prozessorkern/AudioPlayer/pcb/Audioplayer_OG_Prototyp.kicad_pcb

## KiCad design pcb/Audioplayer_OG_Prototyp.kicad_pcb (2018-02-16)

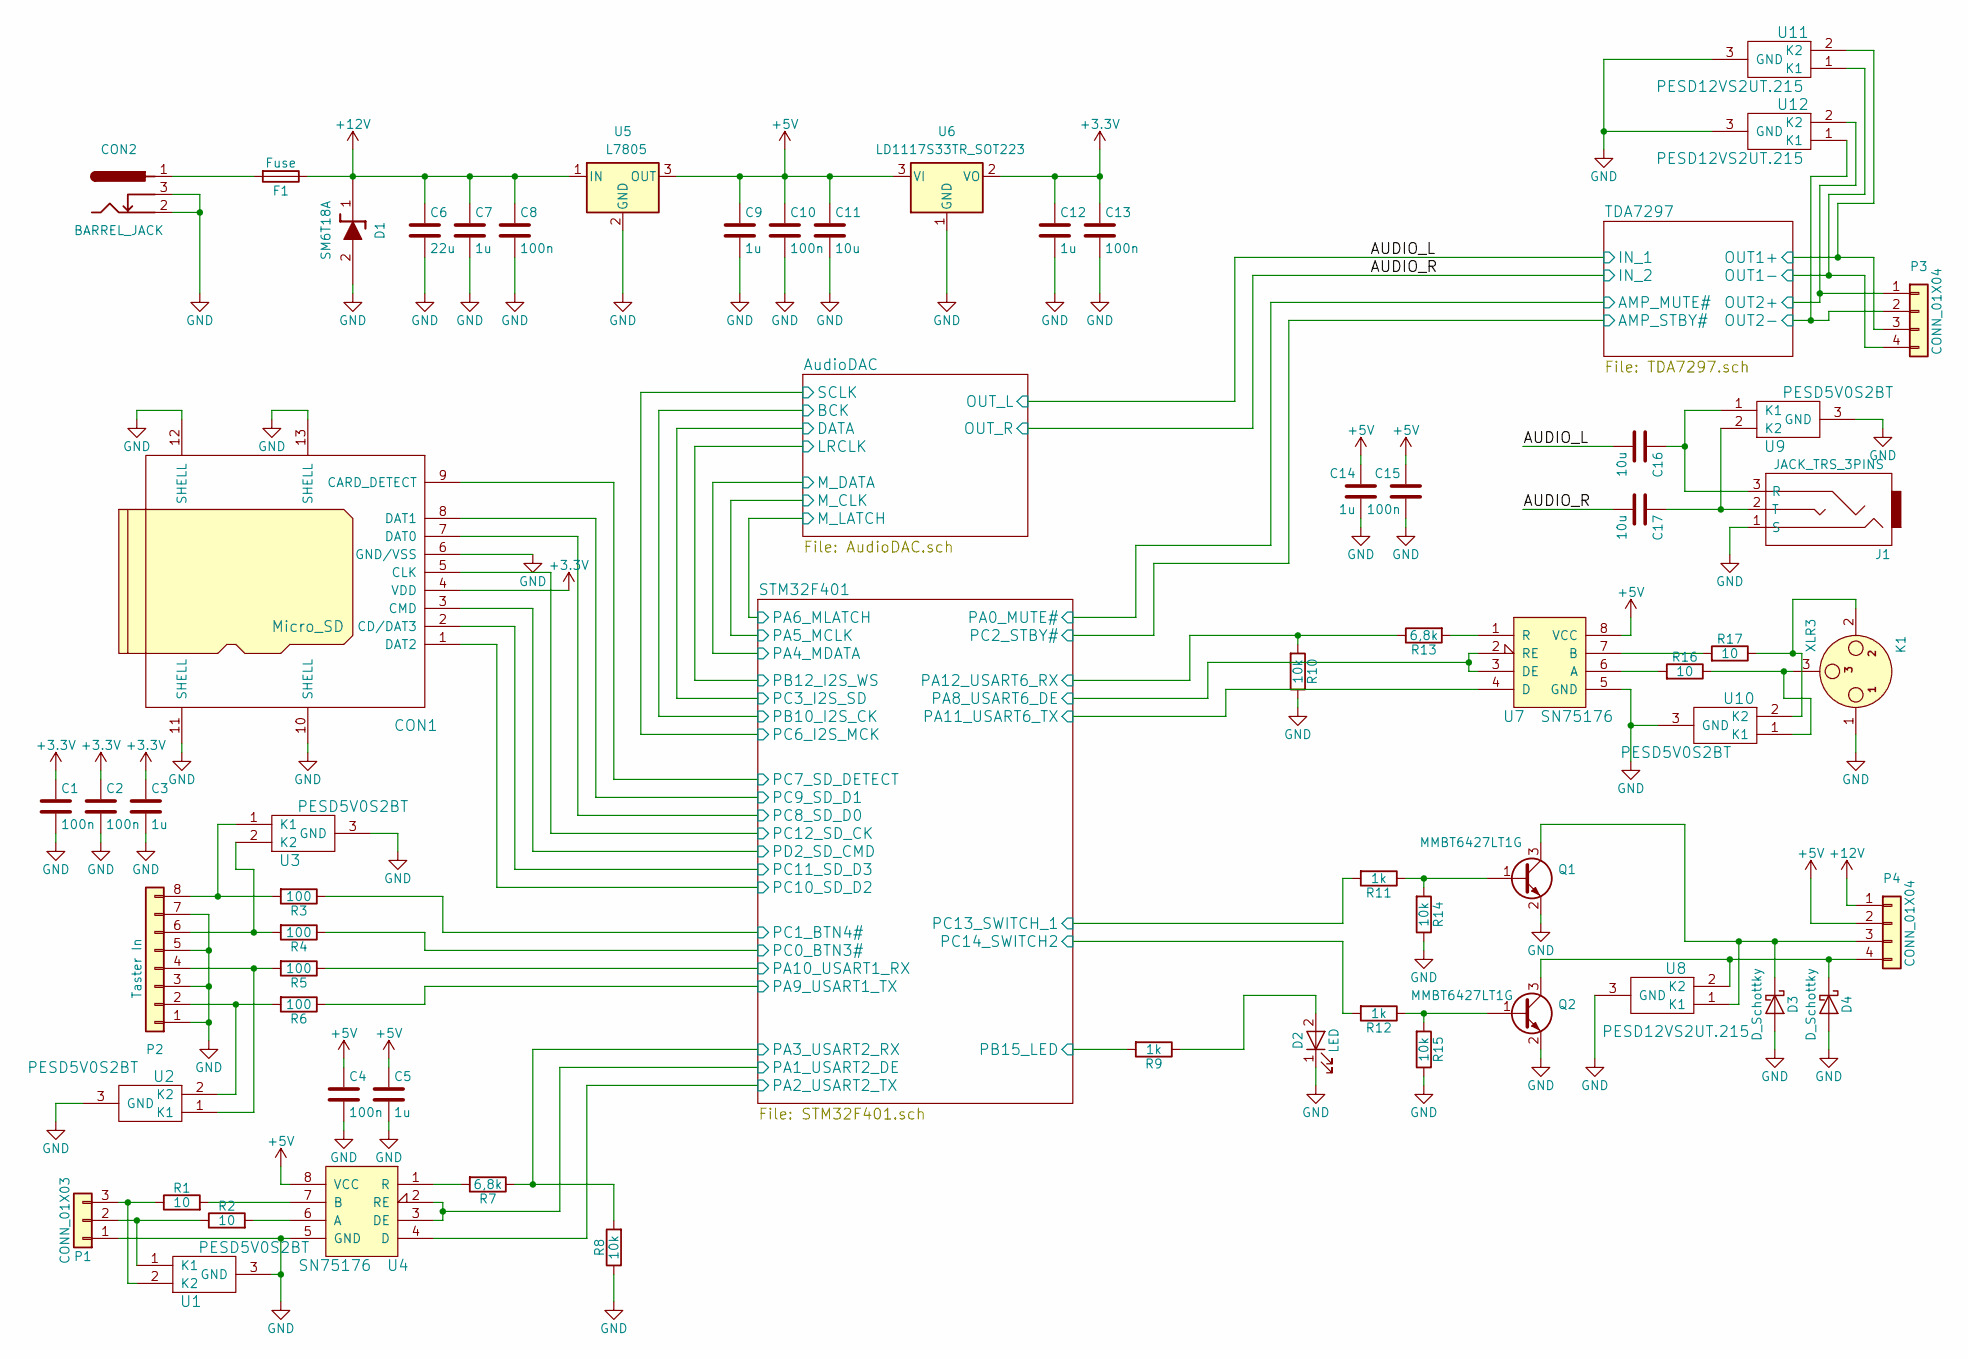
[picture p1: schematic Audioplayer_OG_Prototyp.sch]

Parts:
C1, C2, C4, C10, C13, C15: 100n; C_0603_HandSoldering
C3, C5, C9, C12, C14: 1u; C_0603_HandSoldering
C6: 22u; C_1210_HandSoldering
C7: 1u; C_0805_HandSoldering
C8: 100n; C_0805_HandSoldering
C11, C16, C17: 10u; C_0805_HandSoldering
CON1: Micro_SD
CON2: BARREL_JACK; BARREL_JACK_CLIFF
D1: SM6T18A; D_SMB_Handsoldering
D2: LED; LED_D3.0mm
D3, D4: D_Schottky; D_MELF_Handsoldering
F1: Fuse; Fuseholder5x20_ProFUSE
J1: JACK_TRS_3PINS; LUM_1503-07_Klinke
K1: XLR3; NC3FAH1_XLR_F
P1: CONN_01X03; 3PIN_5,00
P2: Taster In; 8PIN_3,5
P3, P4: CONN_01X04; 4PIN_5,00
Q1, Q2: MMBT6427LT1G; SOT-23_Handsoldering
R1, R2, R16, R17: 10; R_0603_HandSoldering
R3, R4, R5, R6: 100; R_0603_HandSoldering
R7, R13: 6,8k; R_0603_HandSoldering
R8, R10, R14, R15: 10k; R_0603_HandSoldering
R9, R11, R12: 1k; R_0603_HandSoldering
U1, U2, U3, U9, U10: PESD5V0S2BT; SOT-23_Handsoldering
U4, U7: SN75176; SO-8
U5: L7805; TO-263-2
U6: LD1117S33TR_SOT223; SOT-223-3_TabPin2
U8, U11, U12: PESD12VS2UT.215; SOT-23_Handsoldering

Connections:
+5V: C4.1, C5.1, C9.1, C10.1, C11.1, C14.1, C15.1, P4.2, U4.8 (VCC), U5.3 (OUT), U6.3 (VI), U7.8 (VCC); also elsewhere on the board
+12V: C6.1, C7.1, C8.1, D1.1, F1.1, P4.1, U5.1 (IN); also elsewhere on the board
/AUDIO_L: C16.2; also elsewhere on the board
/AUDIO_R: C17.2; also elsewhere on the board
/STM32F401/PA1_USART2_DE: U4.2 (RE), U4.3 (DE); also elsewhere on the board
/STM32F401/PA2_USART2_TX: U4.4 (D); also elsewhere on the board
/STM32F401/PA3_USART2_RX: R7.1, R8.2; also elsewhere on the board
/STM32F401/PA8_USART6_DE: U7.2 (RE), U7.3 (DE); also elsewhere on the board
/STM32F401/PA9_USART1_TX: R6.1; also elsewhere on the board
/STM32F401/PA10_USART1_RX: R5.1; also elsewhere on the board
/STM32F401/PA11_USART6_TX: U7.4 (D); also elsewhere on the board
/STM32F401/PA12_USART6_RX: R10.2, R13.1; also elsewhere on the board
/STM32F401/PB15_LED: R9.2; also elsewhere on the board
/STM32F401/PC0_BTN3#: R4.1; also elsewhere on the board
/STM32F401/PC1_BTN4#: R3.1; also elsewhere on the board
/STM32F401/PC7_SD_DETECT: CON1.9 (CARD_DETECT); also elsewhere on the board
/STM32F401/PC8_SD_D0: CON1.7 (DAT0); also elsewhere on the board
/STM32F401/PC9_SD_D1: CON1.8 (DAT1); also elsewhere on the board
/STM32F401/PC10_SD_D2: CON1.1 (DAT2); also elsewhere on the board
/STM32F401/PC11_SD_D3: CON1.2 (CD/DAT3); also elsewhere on the board
/STM32F401/PC12_SD_CK: CON1.5 (CLK); also elsewhere on the board
/STM32F401/PC13_SWITCH_1: R11.2; also elsewhere on the board
/STM32F401/PC14_SWITCH2: R12.2; also elsewhere on the board
/STM32F401/PD2_SD_CMD: CON1.3 (CMD); also elsewhere on the board
/TDA7297/OUT1+: P3.3, U11.2 (K2); also elsewhere on the board
/TDA7297/OUT1-: P3.4, U11.1 (K1); also elsewhere on the board
/TDA7297/OUT2+: P3.1, U12.2 (K2); also elsewhere on the board
/TDA7297/OUT2-: P3.2, U12.1 (K1); also elsewhere on the board
GND: C1.2, C2.2, C3.2, C4.2, C5.2, C6.2, C7.2, C8.2, C9.2, C10.2, C11.2, C12.2, C13.2, C14.2, C15.2, CON1.6 (GND/VSS), CON1.10 (SHELL), CON1.11 (SHELL), CON1.12 (SHELL), CON1.13 (SHELL), CON2.2, CON2.3, D1.2, D2.1 (K), D3.2 (A), D4.2 (A), J1.1 (S), K1.1, P1.1, P2.1, P2.3, P2.5, P2.7, Q1.2 (E), Q2.2 (E), R8.1, R10.1, R14.1, R15.1, U1.3 (GND), U2.3 (GND), U3.3 (GND), U4.5 (GND), U5.2 (GND), U6.1 (GND), U7.5 (GND), U8.3 (GND), U9.3 (GND), U10.3 (GND), U11.3 (GND), U12.3 (GND); also elsewhere on the board
unnamed: C16.1, J1.3 (R), U9.1 (K1)
unnamed: C17.1, J1.2 (T), U9.2 (K2)
unnamed: CON2.1, F1.2
unnamed: D2.2 (A), R9.1
unnamed: D3.1 (K), P4.3, Q1.3 (C), U8.1 (K1)
unnamed: D4.1 (K), P4.4, Q2.3 (C), U8.2 (K2)
unnamed: K1.2, R17.1, U10.2 (K2)
unnamed: K1.3, R16.1, U10.1 (K1)
unnamed: P1.2, R2.1, U1.1 (K1)
unnamed: P1.3, R1.1, U1.2 (K2)
unnamed: P2.2, R6.2, U2.2 (K2)
unnamed: P2.4, R5.2, U2.1 (K1)
unnamed: P2.6, R4.2, U3.2 (K2)
unnamed: P2.8, R3.2, U3.1 (K1)
unnamed: Q1.1 (B), R11.1, R14.2
unnamed: Q2.1 (B), R12.1, R15.2
unnamed: R1.2, U4.7 (B)
unnamed: R2.2, U4.6 (A)
unnamed: R7.2, U4.1 (R)
unnamed: R13.2, U7.1 (R)
unnamed: R16.2, U7.6 (A)
unnamed: R17.2, U7.7 (B)

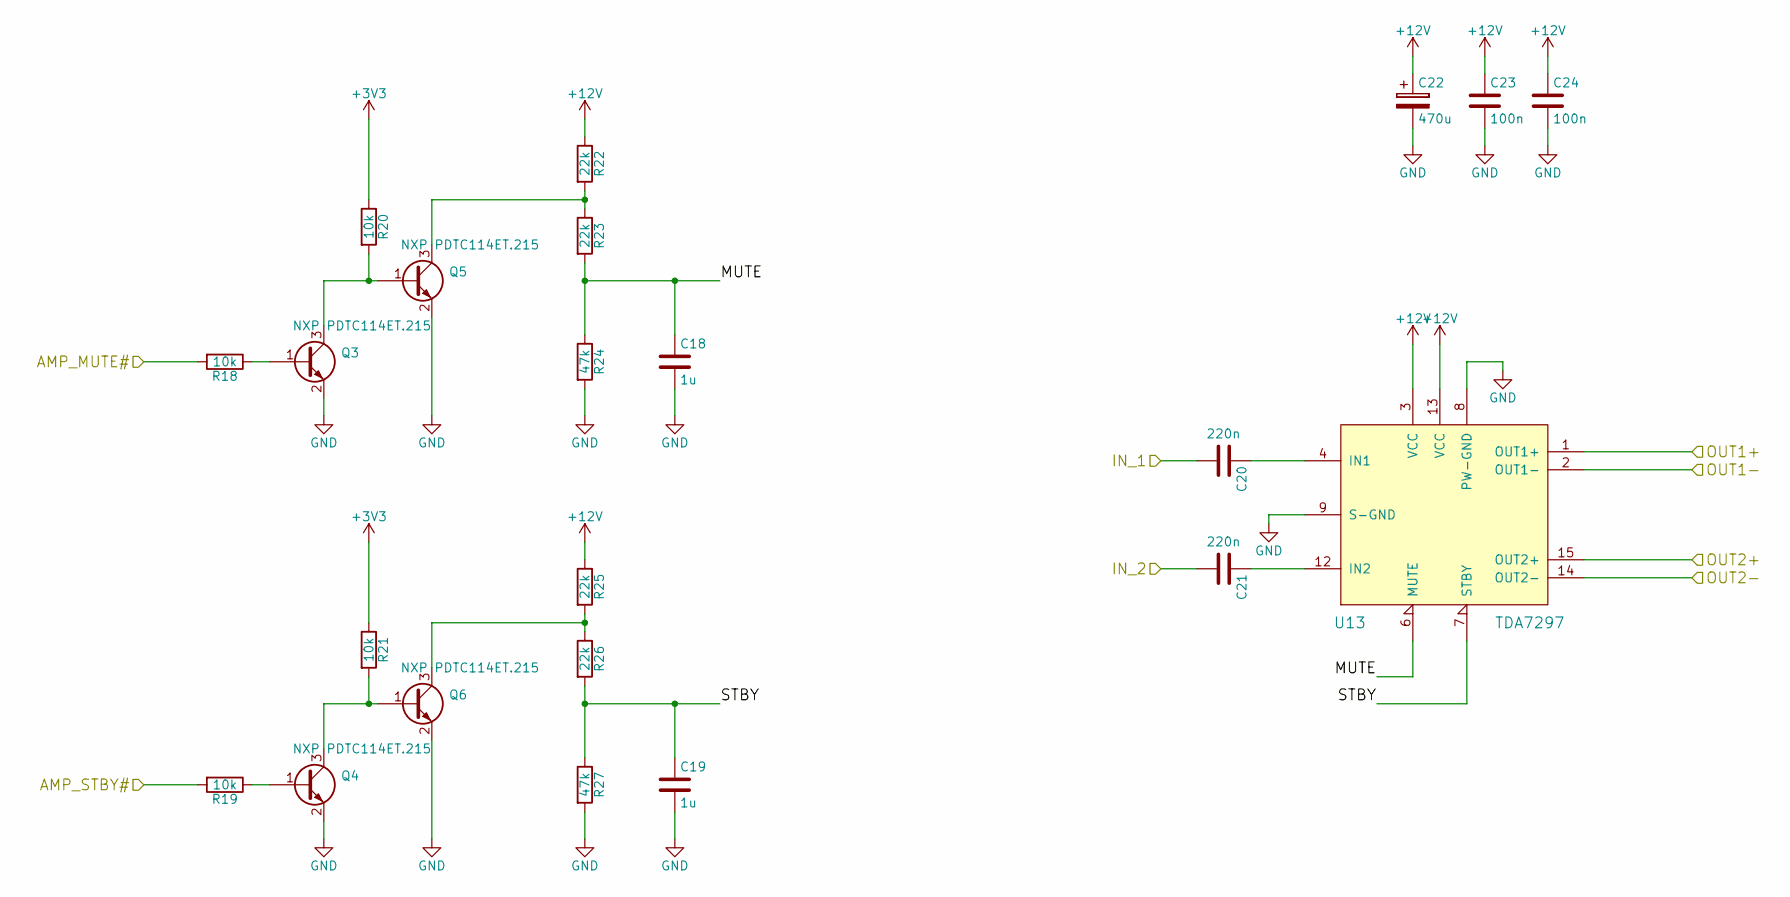
[picture p2: schematic TDA7297.sch]

Parts:
C18, C19: 1u; C_0603_HandSoldering
C20, C21: 220n; C_0603_HandSoldering
C22: 470u; CP_Radial_D10.0mm_P5.00mm
C23, C24: 100n; C_0805_HandSoldering
Q3, Q4, Q5, Q6: NXP PDTC114ET.215; SOT-23_Handsoldering
R18, R19, R20, R21: 10k; R_0603_HandSoldering
R22, R23, R25, R26: 22k; R_0603_HandSoldering
R24, R27: 47k; R_0603_HandSoldering
U13: TDA7297; TO-220-15_Vertical_StaggeredType1

Connections:
+12V: C22.1, C23.1, C24.1, R22.1, R25.1, U13.3 (VCC), U13.13 (VCC); also elsewhere on the board
/AUDIO_L: C20.2; also elsewhere on the board
/AUDIO_R: C21.2; also elsewhere on the board
/TDA7297/AMP_MUTE#: R18.2; also elsewhere on the board
/TDA7297/AMP_STBY#: R19.2; also elsewhere on the board
/TDA7297/MUTE: C18.1, R23.2, R24.1, U13.6 (MUTE)
/TDA7297/OUT1+: U13.1 (OUT1+); also elsewhere on the board
/TDA7297/OUT1-: U13.2 (OUT1-); also elsewhere on the board
/TDA7297/OUT2+: U13.15 (OUT2+); also elsewhere on the board
/TDA7297/OUT2-: U13.14 (OUT2-); also elsewhere on the board
/TDA7297/STBY: C19.1, R26.2, R27.1, U13.7 (STBY)
GND: C18.2, C19.2, C22.2, C23.2, C24.2, Q3.2 (E), Q4.2 (E), Q5.2 (E), Q6.2 (E), R24.2, R27.2, U13.8 (PW-GND), U13.9 (S-GND); also elsewhere on the board
unnamed: C20.1, U13.4 (IN1)
unnamed: C21.1, U13.12 (IN2)
unnamed: Q3.1 (B), R18.1
unnamed: Q3.3 (C), Q5.1 (B), R20.2
unnamed: Q4.1 (B), R19.1
unnamed: Q4.3 (C), Q6.1 (B), R21.2
unnamed: Q5.3 (C), R22.2, R23.1
unnamed: Q6.3 (C), R25.2, R26.1

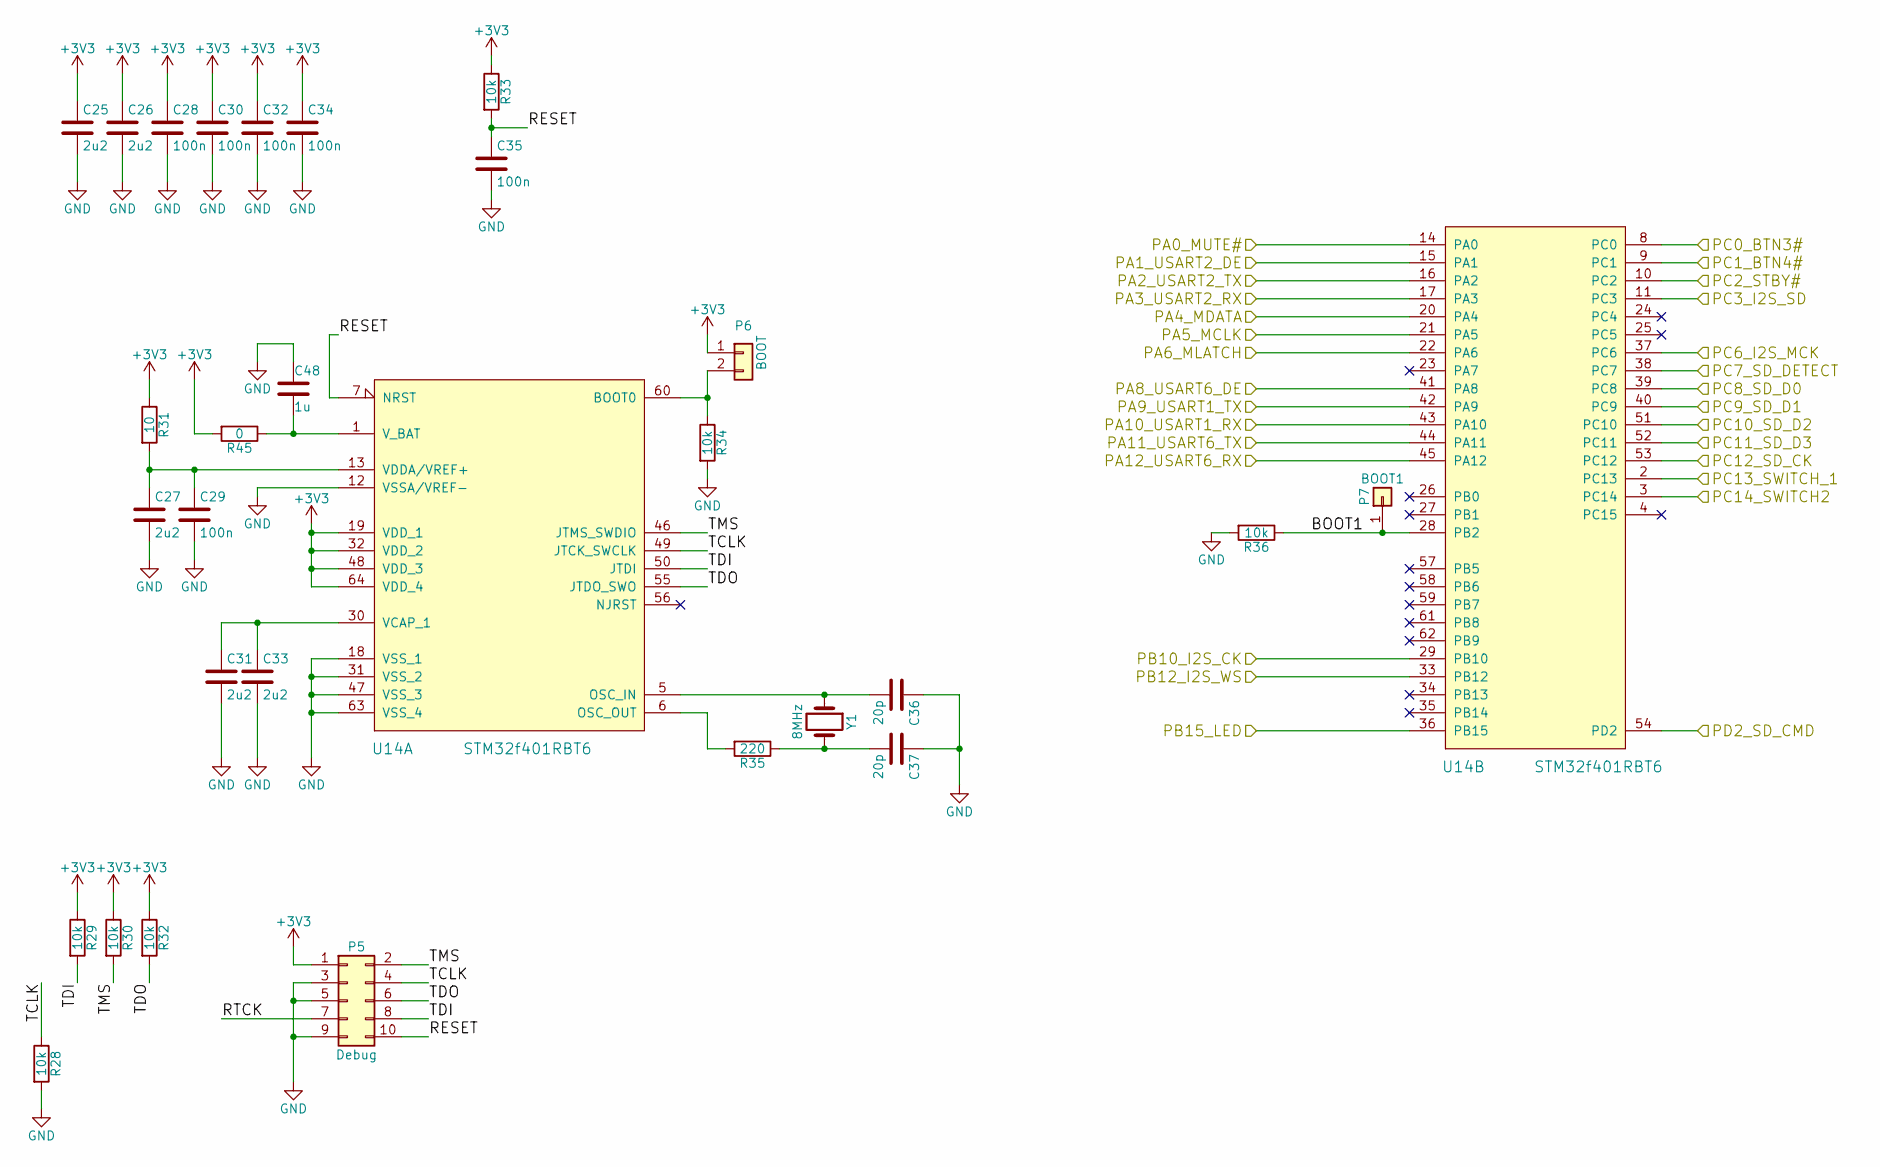
[picture p3: schematic STM32F401.sch]

Parts:
C25, C26, C27, C31, C33: 2u2; C_0603_HandSoldering
C28, C29, C30, C32, C34, C35: 100n; C_0603_HandSoldering
C36, C37: 20p; C_0603_HandSoldering
C48: 1u; C_0603_HandSoldering
P5: Debug; VASCH5x2
P6: BOOT; Pin_Header_Straight_1x02_Pitch2.54mm
P7: BOOT1; Pin_Header_Straight_1x01_Pitch2.54mm
R28, R29, R30, R32, R33, R34, R36: 10k; R_0603_HandSoldering
R31: 10; R_0603_HandSoldering
R35: 220; R_0603_HandSoldering
R45: 0; R_0603_HandSoldering
U14: STM32f401RBT6; LQFP-64_10x10mm_Pitch0.5mm
Y1: 8MHz; Crystal_HC49-U_Vertical

Connections:
/AudioDAC/BCK: U14.29 (PB10); also elsewhere on the board
/AudioDAC/DATA: U14.11 (PC3); also elsewhere on the board
/AudioDAC/LRCLK: U14.33 (PB12); also elsewhere on the board
/AudioDAC/M_CLK: U14.21 (PA5); also elsewhere on the board
/AudioDAC/M_DATA: U14.20 (PA4); also elsewhere on the board
/AudioDAC/M_LATCH: U14.22 (PA6); also elsewhere on the board
/STM32F401/BOOT1: P7.1, R36.1, U14.28 (PB2)
/STM32F401/PA1_USART2_DE: U14.15 (PA1); also elsewhere on the board
/STM32F401/PA2_USART2_TX: U14.16 (PA2); also elsewhere on the board
/STM32F401/PA3_USART2_RX: U14.17 (PA3); also elsewhere on the board
/STM32F401/PA8_USART6_DE: U14.41 (PA8); also elsewhere on the board
/STM32F401/PA9_USART1_TX: U14.42 (PA9); also elsewhere on the board
/STM32F401/PA10_USART1_RX: U14.43 (PA10); also elsewhere on the board
/STM32F401/PA11_USART6_TX: U14.44 (PA11); also elsewhere on the board
/STM32F401/PA12_USART6_RX: U14.45 (PA12); also elsewhere on the board
/STM32F401/PB15_LED: U14.36 (PB15); also elsewhere on the board
/STM32F401/PC0_BTN3#: U14.8 (PC0); also elsewhere on the board
/STM32F401/PC1_BTN4#: U14.9 (PC1); also elsewhere on the board
/STM32F401/PC6_I2S_MCK: U14.37 (PC6); also elsewhere on the board
/STM32F401/PC7_SD_DETECT: U14.38 (PC7); also elsewhere on the board
/STM32F401/PC8_SD_D0: U14.39 (PC8); also elsewhere on the board
/STM32F401/PC9_SD_D1: U14.40 (PC9); also elsewhere on the board
/STM32F401/PC10_SD_D2: U14.51 (PC10); also elsewhere on the board
/STM32F401/PC11_SD_D3: U14.52 (PC11); also elsewhere on the board
/STM32F401/PC12_SD_CK: U14.53 (PC12); also elsewhere on the board
/STM32F401/PC13_SWITCH_1: U14.2 (PC13); also elsewhere on the board
/STM32F401/PC14_SWITCH2: U14.3 (PC14); also elsewhere on the board
/STM32F401/PD2_SD_CMD: U14.54 (PD2); also elsewhere on the board
/STM32F401/RESET: C35.1, P5.10, R33.2, U14.7 (NRST)
/STM32F401/TCLK: P5.4, R28.1, U14.49 (JTCK_SWCLK)
/STM32F401/TDI: P5.8, R29.2, U14.50 (JTDI)
/STM32F401/TDO: P5.6, R32.2, U14.55 (JTDO_SWO)
/STM32F401/TMS: P5.2, R30.2, U14.46 (JTMS_SWDIO)
/TDA7297/AMP_MUTE#: U14.14 (PA0); also elsewhere on the board
/TDA7297/AMP_STBY#: U14.10 (PC2); also elsewhere on the board
GND: C25.2, C26.2, C27.2, C28.2, C29.2, C30.2, C31.2, C32.2, C33.2, C34.2, C35.2, C36.1, C37.1, C48.1, P5.3, P5.5, P5.9, R28.2, R34.2, R36.2, U14.12 (VSSA/VREF-), U14.18 (VSS_1), U14.31 (VSS_2), U14.47 (VSS_3), U14.63 (VSS_4); also elsewhere on the board
unnamed: C27.1, C29.1, R31.2, U14.13 (VDDA/VREF+)
unnamed: C31.1, C33.1, U14.30 (VCAP_1)
unnamed: C36.2, U14.5 (OSC_IN), Y1.1
unnamed: C37.2, R35.1, Y1.2
unnamed: C48.2, R45.1, U14.1 (V_BAT)
unnamed: P6.2, R34.1, U14.60 (BOOT0)
unnamed: R35.2, U14.6 (OSC_OUT)

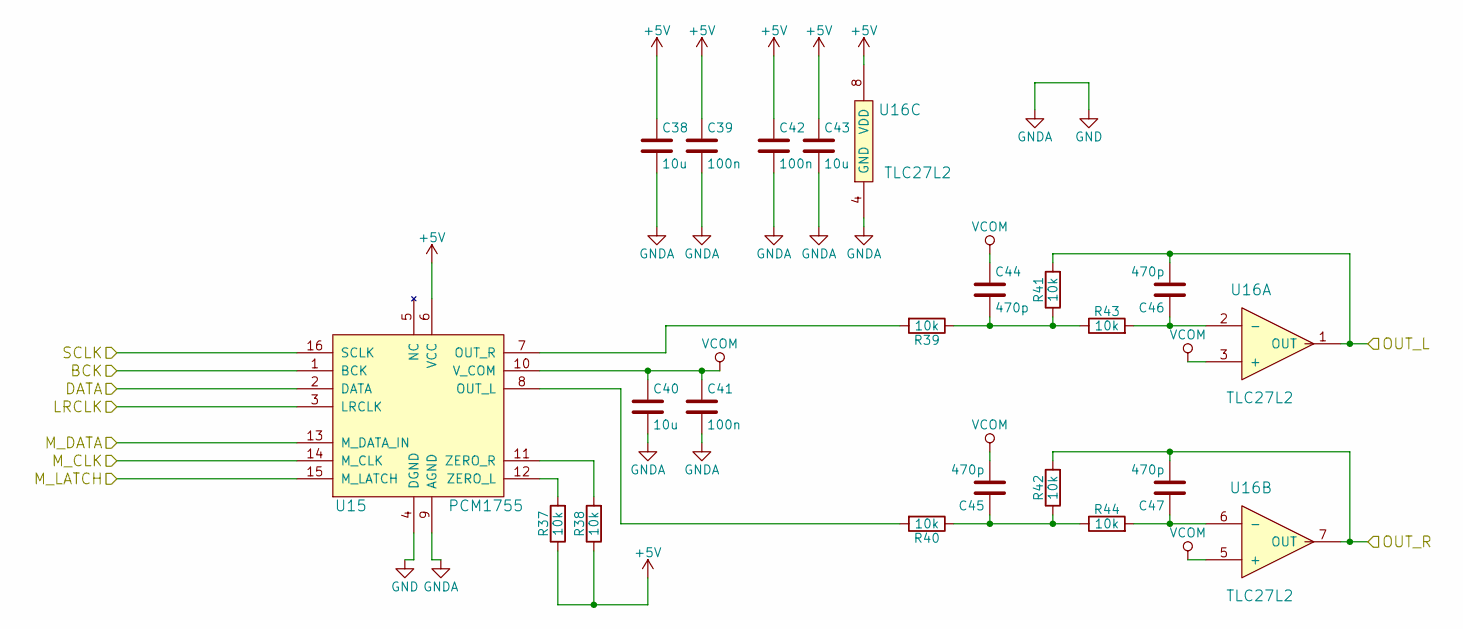
[picture p4: schematic AudioDAC.sch]

Parts:
C38, C40, C43: 10u; C_0805_HandSoldering
C39, C41, C42: 100n; C_0603_HandSoldering
C44, C45, C46, C47: 470p; C_0603_HandSoldering
R37, R38, R39, R40, R41, R42, R43, R44: 10k; R_0603_HandSoldering
U15: PCM1755; SSOP-16_3.9x4.9mm_Pitch0.635mm
U16: TLC27L2; SO-8

Connections:
+5V: C38.1, C39.1, C42.1, C43.1, R37.1, R38.1, U15.6 (VCC), U16.8 (VDD); also elsewhere on the board
/AUDIO_L: C46.2, R41.2, U16.1 (OUT); also elsewhere on the board
/AUDIO_R: C47.2, R42.2, U16.7 (OUT); also elsewhere on the board
/AudioDAC/BCK: U15.1 (BCK); also elsewhere on the board
/AudioDAC/DATA: U15.2 (DATA); also elsewhere on the board
/AudioDAC/LRCLK: U15.3 (LRCLK); also elsewhere on the board
/AudioDAC/M_CLK: U15.14 (M_CLK); also elsewhere on the board
/AudioDAC/M_DATA: U15.13 (M_DATA_IN); also elsewhere on the board
/AudioDAC/M_LATCH: U15.15 (M_LATCH); also elsewhere on the board
/STM32F401/PC6_I2S_MCK: U15.16 (SCLK); also elsewhere on the board
GND: C38.2, C39.2, C40.2, C41.2, C42.2, C43.2, U15.4 (DGND), U15.9 (AGND), U16.4 (GND); also elsewhere on the board
unnamed: C44.2, R39.1, R41.1, R43.1
unnamed: C45.1, R40.1, R42.1, R44.1
unnamed: C46.1, R43.2, U16.2 (-)
unnamed: C47.1, R44.2, U16.6 (-)
unnamed: R37.2, U15.12 (ZERO_L)
unnamed: R38.2, U15.11 (ZERO_R)
unnamed: R39.2, U15.7 (OUT_R)
unnamed: R40.2, U15.8 (OUT_L)
VCOM: C40.1, C41.1, C44.1, C45.2, U15.10 (V_COM), U16.3 (+), U16.5 (+)

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
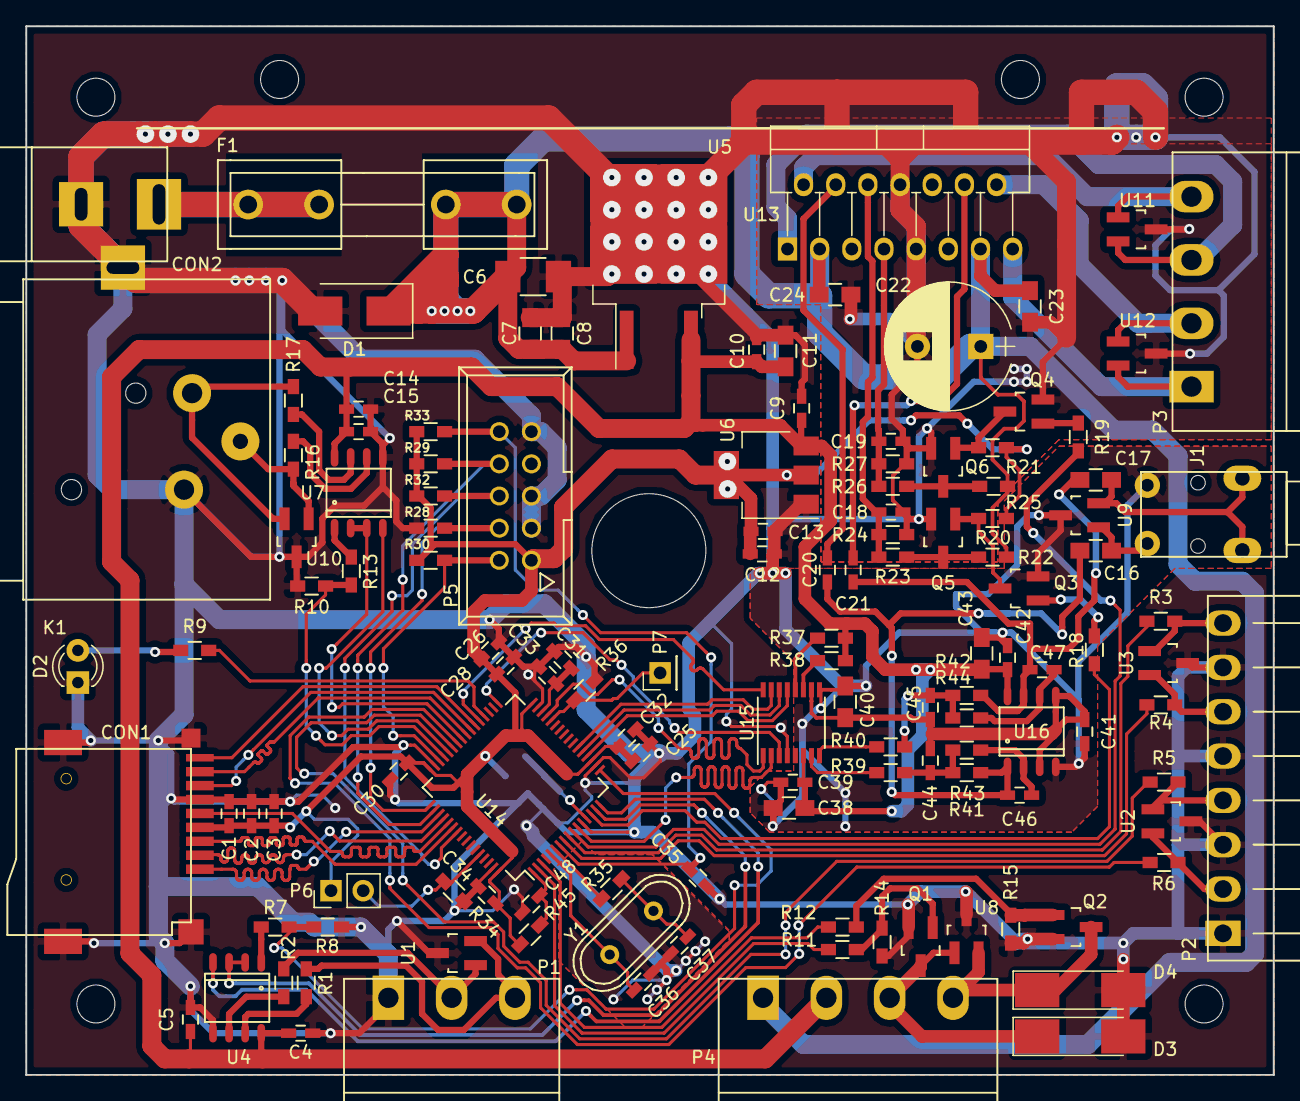
[picture p5: board Audioplayer_OG_Prototyp.kicad_pcb from above]

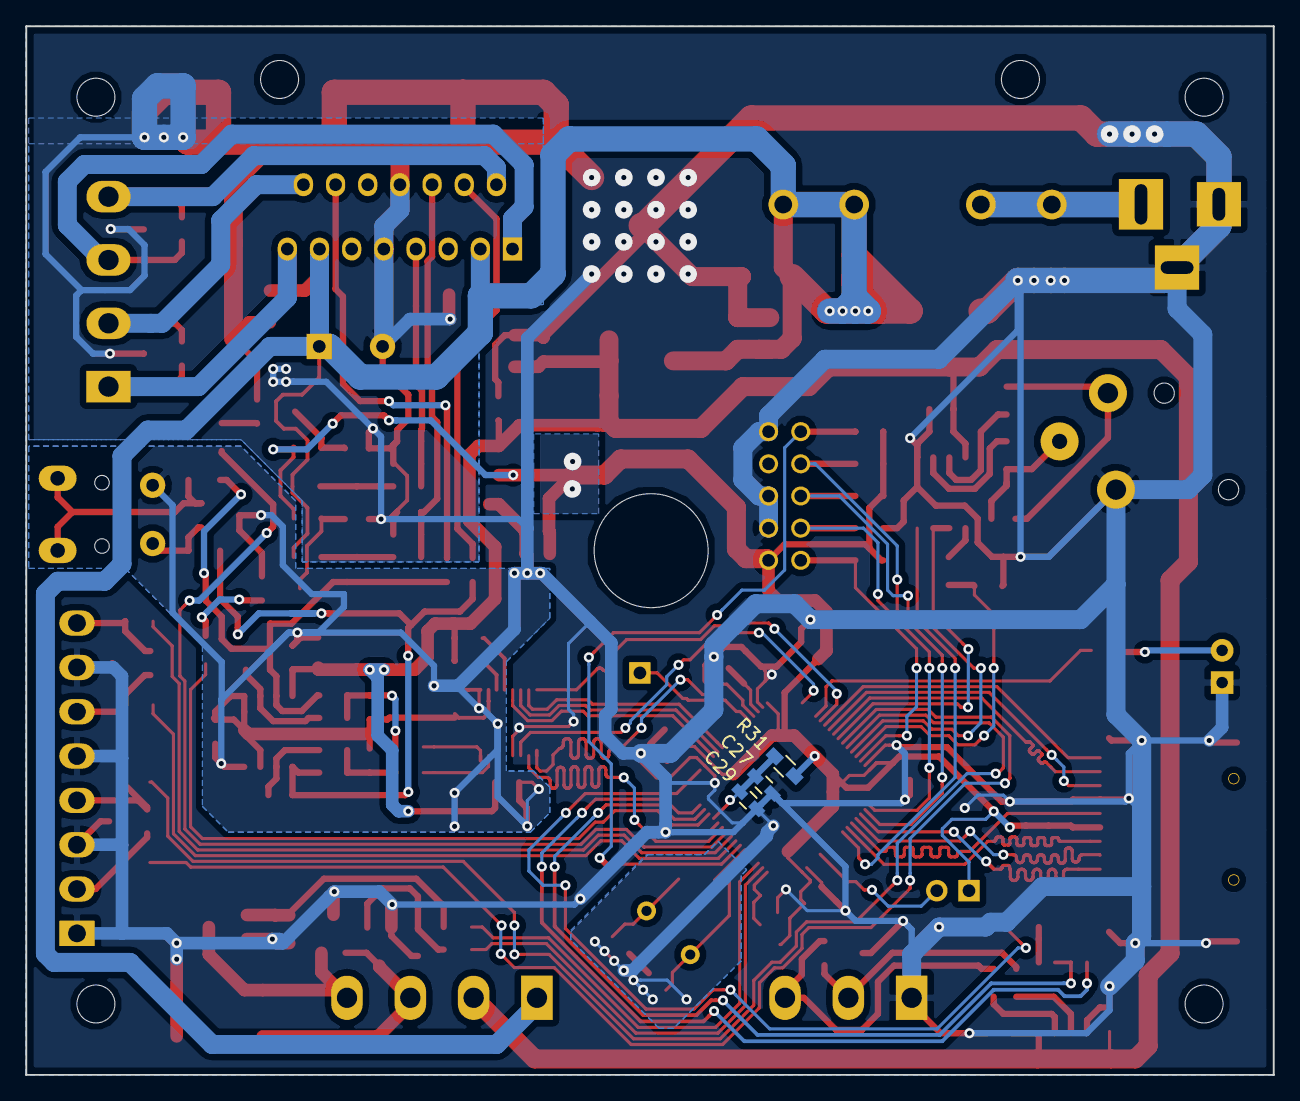
[picture p6: board Audioplayer_OG_Prototyp.kicad_pcb from below]

Board: 2 copper layers, 98.5 x 82.8 mm, 132 parts (3 on the bottom side), 93 nets.
