prozessorkern/AudioPlayer/(commit log)

2018-02-16 commit of the legacy work from another file management system...
    will be cleaned up afterwards
    [AudioDAC.sch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]
2018-02-16 cleaned up the project
    updated the KiCad Projects to run with the shared KiCad Libs
    changed to the new KiCad Lib Symbols and footprints
    simple Layout improvements
    [AudioDAC.sch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]
2018-02-25 added a drawing of additional cutouts for the two extended connectors at the side of the audio player...
